techlabksbg/tinyco2/README.md

# TinyCO2 Sensor

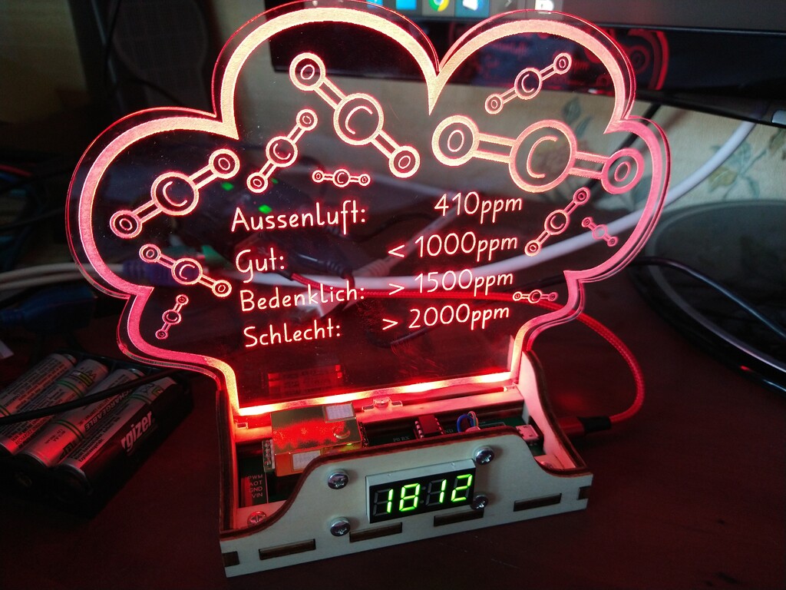
[picture p1: photos/highco2.jpg]
Viel CO2

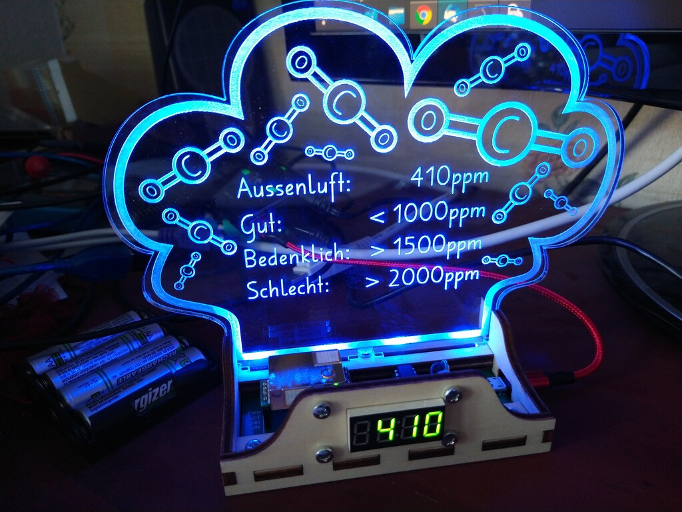
[picture p2: photos/lowco2.jpg]
Wenig CO2


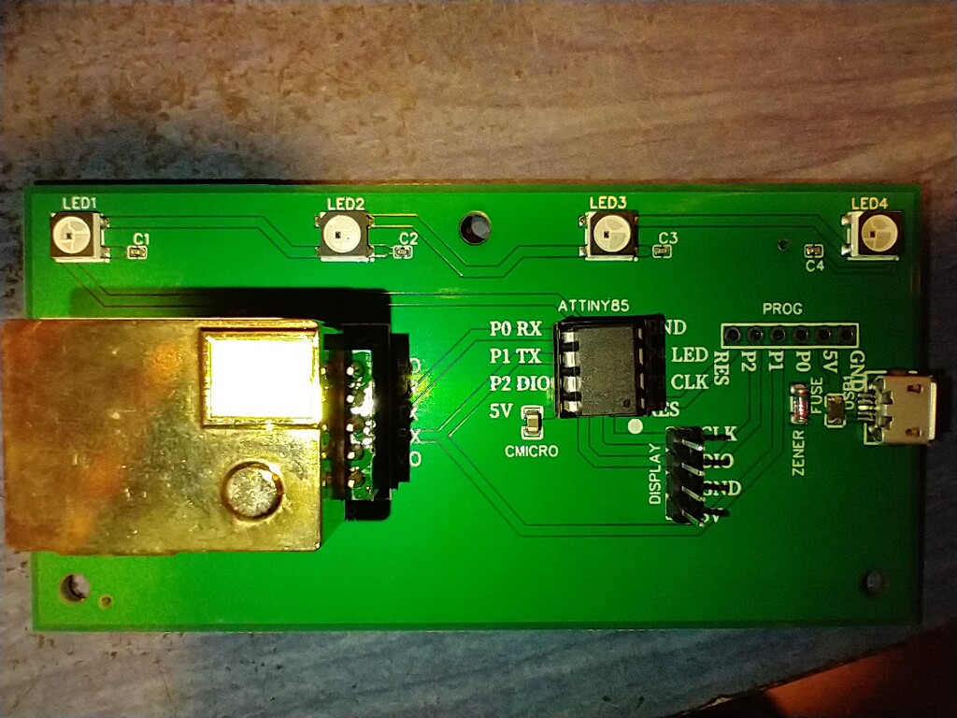
[picture p3: photos/pcb.jpg]
PCB
