techlabksbg/tinyco2/case/artwork.png

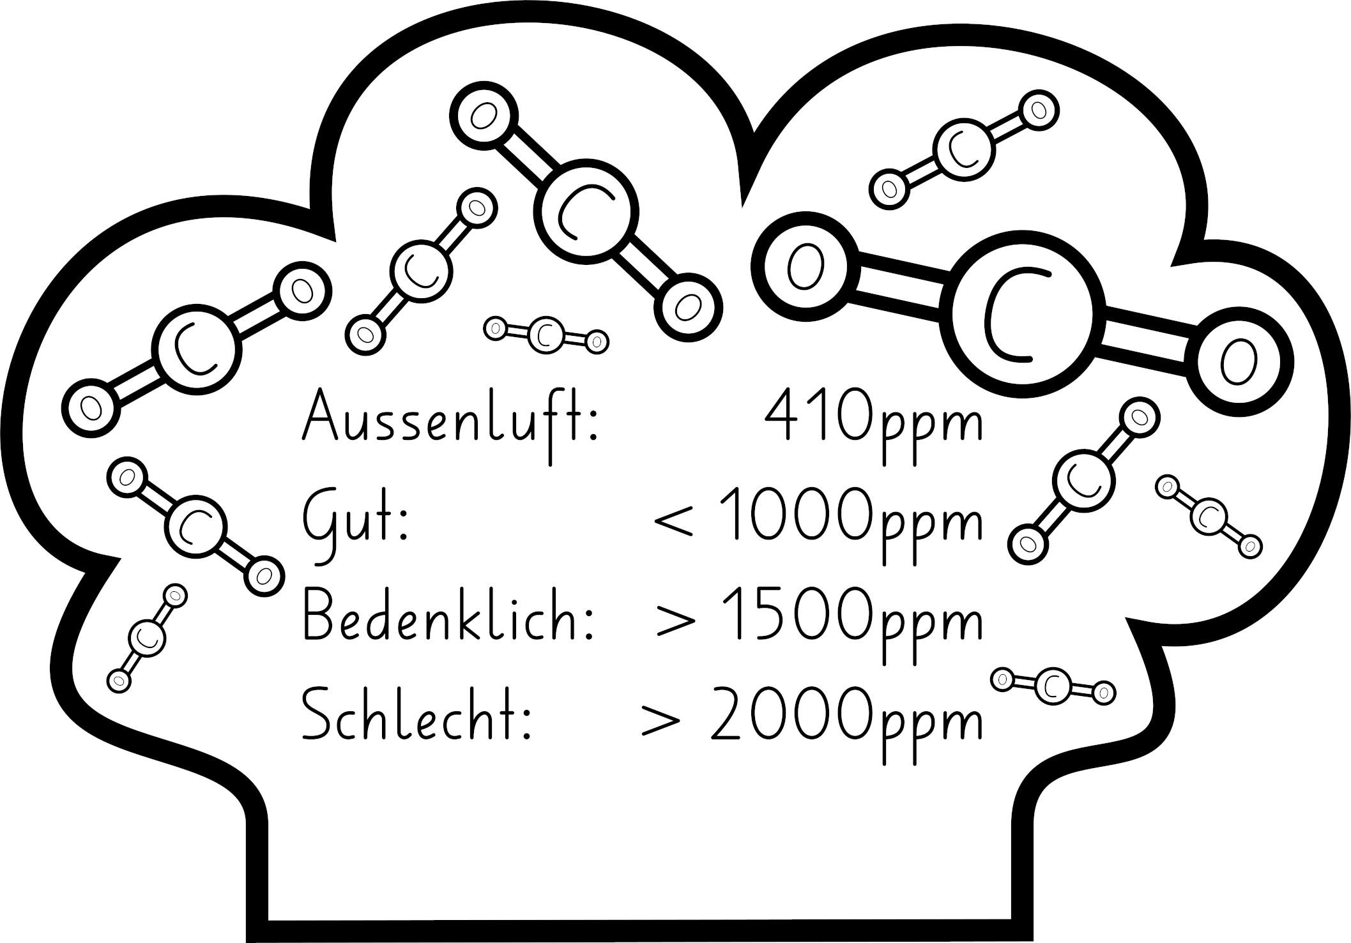
case/artwork.png
