techlabksbg/tinyco2/pcb/BOM_co2basic_2020-10-04_22-47-35.csv

ID | Name | Designator | Footprint | Quantity | Manufacturer Part | Manufacturer | Supplier | Supplier Part | LCSC Assembly
1 | ZMM5V6 | ZENER | LL-34_L3.5-W1.5-RD | 1 | ZMM5V6 | SEMTECH | LCSC | C8062 | Yes
2 | MH-Z19B-01 | U2 | MH-Z19B-01 | 1 | New SchematicLib |  | Misal | M-MH-Z19B
3 | WS2812B-B | LED1,LED2,LED3,LED4 | LED-SMD_4P-L5.0-W5.0-TL_WS2812B-B | 4 | WS2812B-B | Worldsemi | LCSC | C114586 | Yes
4 | 10uF | CMICRO | C0805 | 1 | CL21A106KAYNNNE | SAMSUNG | LCSC | C15850 | Yes
5 | micro USBFemale | USB1 | MICRO-USB-SMD_5P-P0.65-H-F_C10418 | 1 | micro USBFemale | ValuePro | LCSC | C10418
6 | DISPLAY | DISPLAY | HDR-4X1/2.54 | 1 | Header-Female-2.54_1x4 | EasyEDA | EasyEDA
7 | 100nF | C1,C2,C3,C4 | C0402 | 4 | CL05B104KO5NNNC | SAMSUNG | LCSC | C1525 | Yes
8 | AtTiny85 | ATTINY85 | DIP-8 | 1 | ATTINY85-20PU
9 | MF-PSMF010X-2 | FUSE | F0805 | 1 | MF-PSMF010X-2 | BOURNS | LCSC | C116171 | Yes
10 | Header-Female-2.54_1x6 | PROG | HDR-TH_6P-P2.54-V | 1 | Female header 1*6p | BOOMELE | LCSC | C40877
