techlabksbg/tinyco2/case/case-holz.dxf

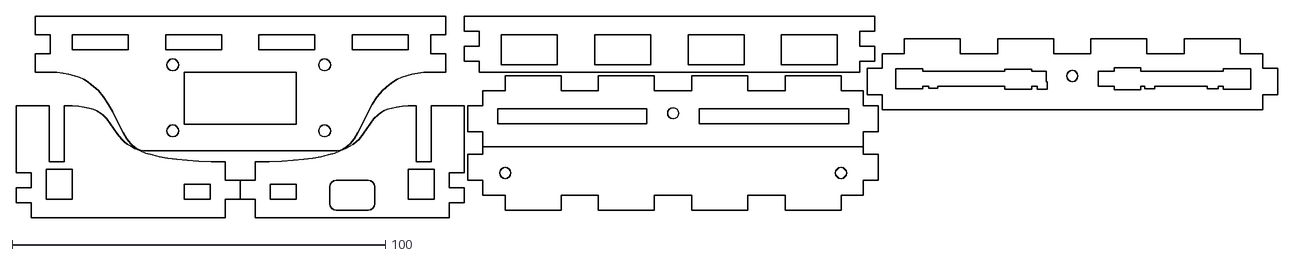
[picture p5: CAD file, 2022-01-18]
case/case-holz.dxf
338.0 x 54.0
