techlabksbg/tinyco2/case/case-acryl.dxf

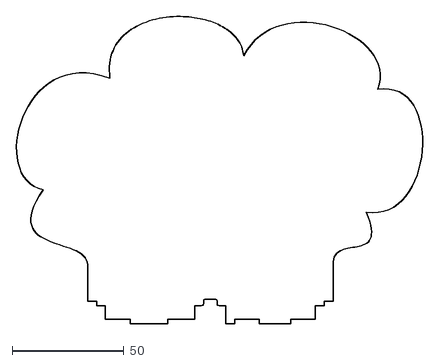
[picture p6: CAD file, 2022-01-18]
case/case-acryl.dxf
182.4 x 137.7
