techlabksbg/tinyco2/(commit log)

2022-01-18 4mm sperrholz und 4mm acryl
    [case-acryl.dxf, case-holz.dxf]
2022-01-18 pcb files
    [BOM_co2basic_2020-10-04_22-47-35.csv, PickAndPlace_PCB_2020-10-03_19-26-57_2020-10-04_22-47-51.csv]
2022-01-18 readme for pcb
2022-01-18 Arduino ATTiny85 Code
2022-01-18 How to order the PCB
